KiloMing/automated-inspection-vehicle/chassis/docs/progress-2026-10-18.md

# 2026-10-18 底盘开发进度

日期按 Asia/Shanghai 记录。此文区分已编写、编译验证与实物验证。

## 今日完成

### 工程整理

- 基于 STM32F103C8、标准外设库和 Keil 工程开发。
- 清理旧 LED、Key、DHT11、MQ7、LoRa 外设业务及旧接收主程序，保留 UART、OLED、启动与系统基础文件。
- 今天最终将底盘迁移到 E:/rosfish/chassis；221 个搬移文件通过前后 SHA256 一致性校验。
- .vscode 工作区配置留在根目录，日志被编辑器占用；头文件路径已改为 chassis 下的路径。
- 将 ROS 2 上位机单独放入 E:/rosfish/upper_computer，不与 MCU 源码混合。

### 编码器

- 两路 A/B 相编码器：TIM2 PA0/PA1；TIM3 PA6/PA7。
- 硬件四倍频，有符号累计计数，处理 16 位硬件计数器回绕。
- 主循环持续读取；约 100 ms 计算窗口增量，DT 输出实际采样时间。
- 先实现转一圈计数测试，再增加增量输出反映转速。
- 每圈计数与减速比尚未确定，因此还没有输出 RPM。
- 用户曾报告运行中编码值逐渐减小：尚未收到用于定位的连续数据，原因未确认。

### TB6612 双电机

- TIM4 CH1/CH2 使用 PB6/PB7 输出 20 kHz PWM。
- AIN1/AIN2 为 PB12/PB13；BIN1/BIN2 为 PB14/PB15。
- STBY 外部拉高，不使用 PB5。
- 提供 Motor_Init、Motor_SetPWM、Motor_Brake、Motor_Coast。
- PWM 接口范围 -1000 至 1000；500 表示 50% 正向占空比，0 表示制动。
- 已加入两路 50% 测试调用；尚无速度闭环。
- 当前用户已注释 Motor_Init()，但两条 Motor_SetPWM() 仍保留。迁移时原样保留此状态，测试电机前需要整理初始化与调用配对。

### HWT101

- USART2：PA3 接模块 TX，PA2 接模块 RX，115200、8N1。
- 中断接收字节及时间戳，主循环解析 11 字节报文并校验。
- 提供 yaw 原始角、heading 相对角、continuous 连续角、相邻航向差分角速度。
- 提供最短角度误差 AngleError，处理正负 180 度跨界，供后续角度闭环调用。
- 数据有效性、帧序号、时间戳、500 ms 超时、串口错误和缓冲溢出处理。
- 断线后不猜测丢失的圈数；普通重连的连续角需重新归零。
- 用户截图显示模块可在厂商上位机以 115200 接收 0x52/0x53 帧，约 10 Hz，显示过 Z 轴角 18.605 度。
- 该截图确认的是模块到电脑通信，不代表 STM32 驱动全部功能已实物验证。

### 串口测试及命令

USART1 调试口 PA9/PA10，9600、8N1，文本模式。综合状态每 200 ms 输出。

```text
ANGLE=18.61 deg,S1=250,S2=248,DT=100
```

ANGLE 为模块原始角度；S1/S2 为最近编码器窗口增量，DT 为窗口毫秒数。

| 命令 | 功能 |
|---|---|
| r/R | 编码器清零 |
| z/Z | MCU 软件相对航向归零，ANGLE 原始角不变 |
| c/C | 发送 HWT101 模块 Z 轴归零 |
| b/B | 发送 HWT101 模块重启，不恢复出厂设置 |

模块命令先解锁再发送。返回 requested 仅表示本地发起，不能作为模块已执行确认。
处理期间显示 IMU=RESETTING，随后重新接收；缺数据时输出 NO_DATA_OR_TIMEOUT。
STM32 RESET 不会自动重启 HWT101。

## 验证记录

- 迁移后 Keil 全量编译：0 错误、0 警告。
- 固件大小：Code=10310，RO-data=398，RW-data=72，ZI-data=3736 字节。
- 编译日志：../Listings/relocation_build.log。
- HWT101 主机解析测试通过：截图报文、校验错误、混合帧、错位恢复、符号比例、跨界、整圈累计、归零、超时、逐字节重连、tick 回绕。
- 测试不代替 GPIO 电平、USART 硬件接收、模块指令执行和实物运动验证。
- 本次未烧录设备，未运行 ROS 2 仿真，未执行上下位机联调。

## 后续顺序

1. 整理电机初始化和启动策略，标定电机/编码器/IMU 的正方向。
2. 测定每圈编码计数，结合采样时间得到 RPM；定位编码增量下降问题。
3. 上板验证 HWT101 角度、归零、重启及断线恢复。
4. 根据闭环需求调整 IMU 输出频率，降低阻塞式串口输出影响。
5. 实现轮速 PID 和角度闭环，明确失联停机、输出限幅与积分复位策略。
6. 定义 ROS 2 与 STM32 通信协议，实现速度下发、轮速/航向反馈和里程计接口。

上位机原有功能见其 README；今日未将其既有仿真功能计作底盘新增成果。

## 上位机仓库拉取结果

- 仓库：git@github.com:KiloMing/automated-inspection-vehicle.git。
- 本地位置：E:/rosfish/upper_computer。
- 分支 main，提交 368e08cca4fdfe862f484ba23d50b863b817d745。
- 克隆成功，工作区干净。保留原有三个 ROS 包：mybot_description、autopatrol_interface、autopatrol_speaker。
- 仓库 README 描述已有 Gazebo、Nav2、AMCL、多点巡航、语音与拍照流程，需在对应 Ubuntu/ROS 2 环境验证。
- 22 端口超时后使用 SSH 443 完成克隆；仅配置仓库本地 SSH 选项，origin 保持用户指定地址。
- 今日只完成上位机下载与结构检查，未安装 ROS 依赖、启动仿真或提交推送。

## 同日版本管理调整

按用户要求，将 Git 管理范围由 upper_computer 提升到 E:/rosfish 根目录。
现有上位机历史保留，远端同时管理 chassis/ 与 upper_computer/。
此前“底盘尚未纳入 Git”“未提交推送”等描述是整理阶段记录，以本节后的仓库历史为准。
提交身份：KiloMing <3402684841@qq.com>。
Keil 编译产物、个人调试状态和主机测试可执行文件排除在提交之外。
