KiloMing/automated-inspection-vehicle/chapt6_ws/diagnostics/2026-10-03/hardware.txt

Hardware Component 1
	name: GazeboSystem
	type: 
	plugin name: 
	state: id=3 label=active
	read/write rate: 0 Hz
	is_async: False
	command interfaces
		left_joint/velocity [available] [unclaimed]
		right_joint/velocity [available] [unclaimed]
