KiloMing/automated-inspection-vehicle/platforms/differential_f103/firmware/docs/progress-2026-10-19.md

# 2026-10-19 开发记录

今天完成了电机速度闭环、航向闭环和蓝牙遥控的联调。最终实车反馈：小车移动正常，蓝牙控制成功。

## 电机采样与标定

从单电机阶梯 PWM 扫描开始，用 VOFA 记录每 20 ms 的编码增量和 PWM。确认轮子周长为 20 cm，每圈对应 2500 编码计数，建立编码增量到 RPM、轮缘速度的换算关系。

电机1原始数据为 `data/vofa+.csv`。按每档后半段估计稳态，在 20%～100% PWM 范围内得到：

```text
编码增量 / 20 ms ≈ 3.280042 × PWM(%) - 14.452265
车轮 RPM ≈ 3.936050 × PWM(%) - 17.342718
轮缘速度(m/s) ≈ 0.01312017 × PWM(%) - 0.05780906
```

本次上升扫描在 14% 档开始持续转动，拟合 R² 为 0.99976670。该结果用于本次工况下的速度估计，不直接外推到低速启动。原始数据、分析脚本、分档结果和曲线均保留在 data 目录。电机2也完成采集，原始数据为 `motor_2vofa+.csv`；本次没有新增电机2拟合报告。

## 双电机速度控制

将纯 PID 算法放入 MotorPID，采样、目标值和 PWM 输出封装到 MotorControl。两路各自保存积分及历史状态，使用相同增益 KP=8500、KI=2000、KD=0。

TIM1 每 20 ms 采样两路编码器。目标值接口使用计数/20 ms，PID 内部换算成 m/s，输出使用千分制 PWM。零目标清空积分并停车，采样未及时处理时停止两路输出。

遥控加入 20% 起步 PWM 下限，仅在接近静止且有驱动需求时生效。转起来后使用 PID 输出。PID 计算期间只屏蔽采样中断，让两个串口继续接收，避免换向延时阻塞接收。

## 航向控制

在 HWT101 连续角度基础上加入角度外环，由双电机速度内环执行差速目标。支持相对转角、到位保持及外界扰动后的纠偏，实车航向测试通过。

方向已确认：电机1左轮，电机2右轮；顺时针角度减小。独立 HeadingControl 接口保留，当前遥控使用自身的航向目标管理，不同时调用两套控制流程。

## 蓝牙遥控

沿用 USART1 的接线与 115200 波特率，不修改 UART.c/h。增加接收中断缓存和主循环解析，支持带空格的 `[j,LX,LY,RX,RY]` 数据包。

左 Y 控制前后，右 X 控制转向，直行保持航向，两轴回中停车。首次连接直接接受有效指令，不要求 APP 先发零值包。

联调中处理了以下问题：

- 数据包带空格，解析器需要兼容。
- 新角度帧的时间戳可能晚于函数入口时间，改为读取角度后再取当前时间，避免无符号时间差误判超时。
- APP 推住摇杆时不持续发包，原来的 300 ms 收包超时导致走一下就停；按要求关闭该判断，保持最后一条有效指令。

关闭遥控超时后，蓝牙断开不会自动触发超时停车。陀螺仪数据异常、接收错误和电机控制超时保护仍保留，故障后需要回中才能继续。

最终用户确认小车移动完全正常，蓝牙遥控成功。当前串口不发送调试数据。

## 验证与后续

已通过遥控解析、保持指令、可选超时模式、串口缓存等主机测试，Keil 固件编译为 0 错误、0 警告。主机测试用于检查软件逻辑，实车结论来自本次联调反馈，尚未测量航向精度或长时间运行误差。

上位机本次未修改业务逻辑。后续需要定义速度指令与反馈协议，接通轮速、航向和里程计，再做 ROS 2 实车导航联调。
