KiloMing/automated-inspection-vehicle/platforms/mecanum_f407/docs/daily/2026-11-04.md

# 2026-11-04 开发记录

## 用户反馈

提供 `mecanumws2`，确认为最新可使用的上位机代码，要求提交并推送 GitHub。此状态来自开发者反馈，本次未运行项目、编译、仿真或实车测试。

## 归档范围

原样同步至 `platforms/mecanum_f407/ros2_ws/`，保留原两套车型分类。旧版本可通过 Git 历史追溯。

- 更新 `config/nav2_real.yaml`。
- 更新 `start_nv2.launch.py`，默认地图改为 `/home/cat/mecanumws/maps/my_map.yaml`。
- 用 `my_map.pgm` / `my_map.yaml` 替换旧 `inspection_map` 文件。
- 新增 `mecanum_straight_planner` 包及插件声明。
- 当前配置实际启用 Navfn 与 Regulated Pure Pursuit；自定义直线规划器配置仍为注释。

## 状态与验证范围

2026-11-03 的问题记录不改写。本次将最新状态更新为用户确认可用，尚未提供测试路线、定位/跟踪误差、成功率或各问题关闭情况。

仅核对同步文件和 Git 提交状态，不据此声称构建或测试通过。源目录名称为 mecanumws2，代码中的板端默认路径仍为 /home/cat/mecanumws；本次不修改用户提供的部署路径。
