KiloMing/automated-inspection-vehicle/platforms/mecanum_f407/docs/daily/2026-11-03.md

# 2026-11-03 开发记录

## 当日进展（用户现场反馈）

- 已完成麦克纳姆小车实物平台上的 Nav2 部署与初步导航联调。
- 当前上位机为鲁班猫 RK3588。
- 使用 Nav2 提供的路径规划与控制组件，实车仍出现路径跟踪与底盘运动偏差，无法正常完成导航。
- 补充底盘装配照片、商家底盘/麦轮尺寸截图、电机编码器资料和维特智能文档链接。

## 状态结论

已进入实车导航联调阶段，尚未通过正常导航验收。用户认为规划与底盘控制存在偏差；具体根因尚未通过日志和测量确定。本记录不将问题归因于某个算法。

## 本次仓库整理

将 F103 固件、二轮差速仿真和旧资料归为一类；F407 固件、麦轮实车工作区及硬件资料归为一类。新增详细 README、硬件索引、原始图片和每日记录。

源码基线为 96b41a1；该版本仅表示分析所依据的仓库版本，不表示板端实际烧录/运行版本。本次未运行项目代码、编译、仿真或硬件测试。

## 待补充实验条件

鲁班猫具体型号、Ubuntu/ROS 2 版本、实际固件提交号、地图版本、启动参数、测试场地、目标点和偏差数值尚未提供。当前不填写推测数值。

## 下一步实验建议

1. 修复并验证运动指令隔离。
2. 独立验证前进、横移与旋转，记录轮序、方向和实际位移。
3. 测量每圈编码器计数、轮中心距、有效轮径并核对固件参数。
4. 对比实际位移、odom、TF 与地图定位。
5. 同步保存速度指令、里程计、激光及 TF 数据，再判断导航参数调整方向。

这些是后续计划，本次没有执行。
