KiloMing/automated-inspection-vehicle/chapt6_ws/photo/C.jpg

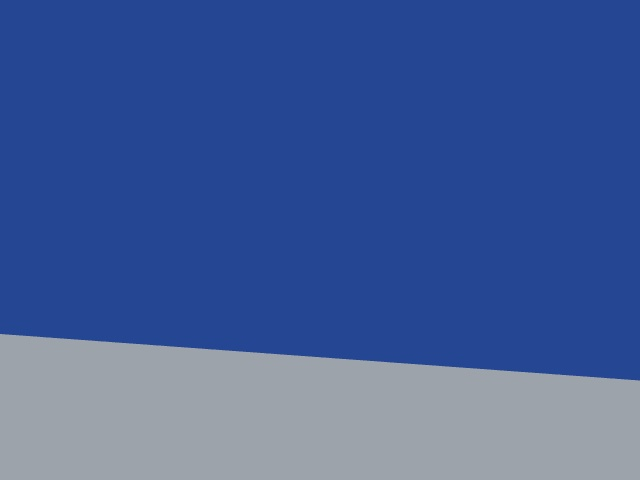
chapt6_ws/photo/C.jpg
