KiloMing/automated-inspection-vehicle/chapt6_ws/photo/D.jpg

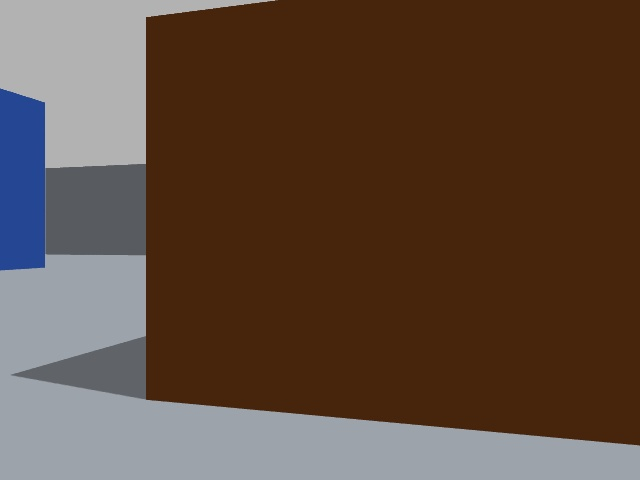
chapt6_ws/photo/D.jpg
