KiloMing/automated-inspection-vehicle/chapt6_ws/photo/photoB.jpg

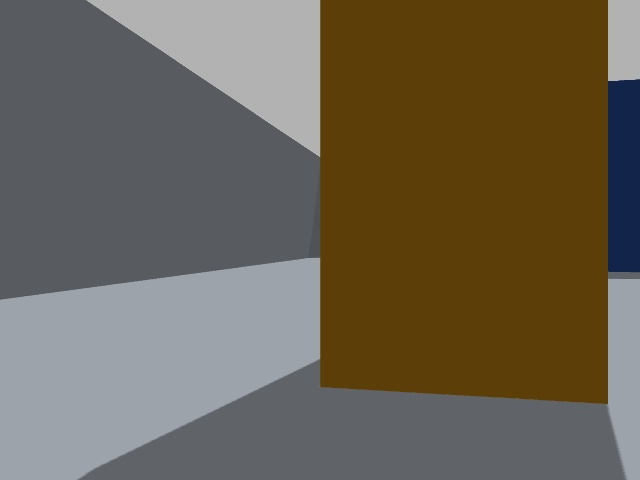
chapt6_ws/photo/photoB.jpg
