KiloMing/automated-inspection-vehicle/upper_computer/docs/images/camsense-x1-mapping-2026-10-23.jpg

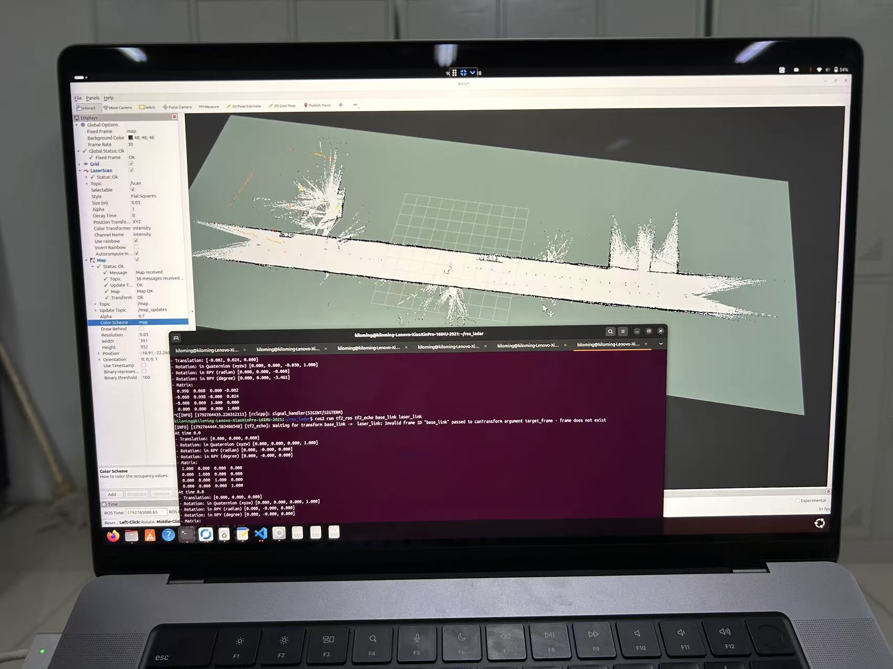
upper_computer/docs/images/camsense-x1-mapping-2026-10-23.jpg
