KiloMing/automated-inspection-vehicle/platforms/differential_f103/firmware/docs/motor1-calibration-2026-10-19.md

# 电机 1 标定结果记录（2026-10-19）

## 数据与测试条件

- 原始数据：[vofa+.csv](../../data/vofa+.csv)，2795 个采样点，一次完整上升扫描。
- 分档统计：[motor1_calibration.csv](../../data/motor1_calibration.csv)。
- 分析报告与曲线：[报告](../../data/motor1_calibration.md)、[曲线](../../data/motor1_calibration.png)。
- 仅测试电机 1 当前扫描方向，串口 115200，通道依次为编码增量、PWM 百分比。
- 采样周期按固件配置 20 ms；每档保持 1 s，PWM 每档增加 2%。
- 每个非零 PWM 档有 50 点，取后 25 点平均，排除前半段加速过程。
- 车轮每圈 2500 计数，周长 0.20 m。CSV 无时间戳，无法独立确认实际采样周期和丢包情况。
- 供电电压、负载及是否架空未记录；本次参数不能视为所有工况通用值。

## 测量结果

| PWM (%) | 平均编码增量/20 ms | 车轮 RPM | 轮缘速度 (m/s) |
|---:|---:|---:|---:|
| 12 | 0.00 | 0.00 | 0.0000 |
| 14 | 30.56 | 36.67 | 0.1222 |
| 20 | 50.56 | 60.67 | 0.2022 |
| 30 | 83.24 | 99.89 | 0.3330 |
| 40 | 116.92 | 140.30 | 0.4677 |
| 50 | 149.68 | 179.62 | 0.5987 |
| 60 | 182.36 | 218.83 | 0.7294 |
| 70 | 216.28 | 259.54 | 0.8651 |
| 80 | 249.80 | 299.76 | 0.9992 |
| 90 | 280.64 | 336.77 | 1.1226 |
| 100 | 309.48 | 371.38 | 1.2379 |

本次扫描在 14% 开始持续转动；这是此次上升扫描的观察值，不是已验证的通用启动阈值。

## 换算与拟合

令 N 为每 20 ms 编码增量，P 为 PWM 百分数（50 表示 50%），v 为轮缘速度（m/s）。

```text
RPM = 1.2 × N
v = 0.004 × N

N   ≈ 3.280042 × P − 14.452265
RPM ≈ 3.936050 × P − 17.342718
v   ≈ 0.01312017 × P − 0.05780906

P ≈ (v + 0.05780906) / 0.01312017
P ≈ (目标 RPM + 17.342718) / 3.936050
```

拟合使用 20%～100% 的 41 个档位均值，R² = 0.99976670，最大绝对残差为 4.072 计数/20 ms。
公式用于本次测试条件下的前馈初值，不外推到低速启动区。

驱动接口使用千分制：`Motor_SetPWM(1, u)` 中 `u ≈ 10 × P`。
例如目标 0.6 m/s，P 约 50.14%，u 约 501。
目标速度为 0 时直接输出 0；非零输出需限幅，低速启动策略另行实现。
轮缘速度不等于打滑条件下的车辆实际地速。

## 后续控制依据

采用目标速度到 PWM 的前馈，再用编码器速度反馈和 PI 修正负载、电压变化。
电机 2、反向、不同负载及启动/降速特性仍需单独测试。
本次仅记录标定结果，尚未将拟合公式或速度闭环加入固件。
