KiloMing/automated-inspection-vehicle/platforms/differential_f103/ros2_ws/diagnostics/2026-10-03/test-controllers.txt

codex_verify_joints   joint_state_broadcaster/JointStateBroadcaster        active
codex_verify_velocity forward_command_controller/ForwardCommandController  active
