KiloMing/automated-inspection-vehicle/platforms/differential_f103/calibration/motor_2vofa+.csv

I0 | I1
0.000000 | 0.000000
0.000000 | 0.000000
0.000000 | 0.000000
0.000000 | 0.000000
0.000000 | 0.000000
0.000000 | 0.000000
0.000000 | 0.000000
0.000000 | 0.000000
0.000000 | 0.000000
0.000000 | 0.000000
0.000000 | 0.000000
0.000000 | 0.000000
0.000000 | 0.000000
0.000000 | 0.000000
0.000000 | 0.000000
0.000000 | 0.000000
0.000000 | 0.000000
0.000000 | 0.000000
0.000000 | 0.000000
0.000000 | 0.000000
0.000000 | 0.000000
0.000000 | 0.000000
0.000000 | 0.000000
0.000000 | 0.000000
0.000000 | 0.000000
0.000000 | 0.000000
0.000000 | 0.000000
0.000000 | 0.000000
0.000000 | 0.000000
0.000000 | 0.000000
0.000000 | 0.000000
0.000000 | 0.000000
0.000000 | 0.000000
0.000000 | 0.000000
0.000000 | 0.000000
0.000000 | 0.000000
0.000000 | 0.000000
0.000000 | 0.000000
0.000000 | 0.000000
0.000000 | 0.000000
0.000000 | 0.000000
0.000000 | 0.000000
0.000000 | 0.000000
0.000000 | 0.000000
0.000000 | 0.000000
0.000000 | 0.000000
0.000000 | 0.000000
0.000000 | 0.000000
0.000000 | 0.000000
0.000000 | 0.000000
0.000000 | 0.000000
0.000000 | 0.000000
0.000000 | 0.000000
0.000000 | 0.000000
0.000000 | 0.000000
0.000000 | 0.000000
0.000000 | 0.000000
0.000000 | 0.000000
0.000000 | 0.000000
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
