KiloMing/automated-inspection-vehicle/data/motor1_calibration.csv

pwm_percent | samples | encoder_mean | encoder_std | encoder_min | encoder_max | wheel_rpm | wheel_speed_m_s
2 | 25 | 0.000000 | 0.000000 | 0.000000 | 0.000000 | 0.000000 | 0.000000
4 | 25 | 0.000000 | 0.000000 | 0.000000 | 0.000000 | 0.000000 | 0.000000
6 | 25 | 0.000000 | 0.000000 | 0.000000 | 0.000000 | 0.000000 | 0.000000
8 | 25 | 0.000000 | 0.000000 | 0.000000 | 0.000000 | 0.000000 | 0.000000
10 | 25 | 0.000000 | 0.000000 | 0.000000 | 0.000000 | 0.000000 | 0.000000
12 | 25 | 0.000000 | 0.000000 | 0.000000 | 0.000000 | 0.000000 | 0.000000
14 | 25 | 30.560000 | 0.583095 | 29.000000 | 31.000000 | 36.672000 | 0.122240
16 | 25 | 37.360000 | 0.489898 | 37.000000 | 38.000000 | 44.832000 | 0.149440
18 | 25 | 44.000000 | 0.408248 | 43.000000 | 45.000000 | 52.800000 | 0.176000
20 | 25 | 50.560000 | 0.506623 | 50.000000 | 51.000000 | 60.672000 | 0.202240
22 | 25 | 57.080000 | 0.400000 | 56.000000 | 58.000000 | 68.496000 | 0.228320
24 | 25 | 63.720000 | 0.458258 | 63.000000 | 64.000000 | 76.464000 | 0.254880
26 | 25 | 70.160000 | 0.374166 | 70.000000 | 71.000000 | 84.192000 | 0.280640
28 | 25 | 76.680000 | 0.476095 | 76.000000 | 77.000000 | 92.016000 | 0.306720
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
