KiloMing/automated-inspection-vehicle/docs/f407-development-history.md

## 当前坐标遥测：24 字节二进制包（替代所有下文文本坐标格式）

50Hz、115200 8N1、异步发送；无换行或帧尾。运动命令仍为 `[v,x,y,z]`，20Hz 持续发送，300ms 超时停车。

|偏移|字段|格式|
|---|---|---|
|0..1|帧头|AA 55|
|2|类型|01|
|3|整帧长度|18（十六进制，24字节）|
|4..5|序号|uint16，小端，从0递增并回绕，忙时丢帧也递增|
|6..9|时间戳|uint32，小端，上电毫秒数|
|10..13|X|IEEE754 float32，小端，米|
|14..17|Y|IEEE754 float32，小端，米|
|18..21|O|IEEE754 float32，小端，度，左正右负，相对归零方向|
|22..23|CRC|CRC16/MODBUS，初值FFFF，多项式A001，覆盖前22字节，低字节先，无最终异或|

坐标失效时三个浮点字段均为 quiet NaN（原始位 0x7FC00000）。上位机按帧头缓存满24字节，核对类型、长度和CRC后解析，CRC错误时滑动一字节重新同步；不能把一次接收当成一帧。不能再用 FireWater 直接解析。

测试样例：序号100、时间8000ms、X=0.12m、Y=0.05m、O=90度：

```text
AA 55 01 18 64 00 40 1F 00 00 8F C2 F5 3D CD CC 4C 3D 00 00 B4 42 55 0C
```

仅完成源码修改与主机侧协议计算检查，未编译固件或烧录。

## 运动命令超时保护

上位机以 20Hz 连续发送 `[v,x,y,z]`，无需改变帧格式。每次有效命令更新速度与接收时间；300ms 无有效命令立即输出停止并清零积分，超时期间禁用航向辅助输出。恢复有效命令后自动恢复控制。启动前 5 秒的命令仍丢弃，上位机持续发送即可在初始化后接管。

超时参数：`ChassisConfig.h` 中 `CHASSIS_COMMAND_TIMEOUT_MS=300U`。坐标 `x,y,o` 保持 50Hz 非阻塞发送。停止指令为 `[v,0,0,0]`；超时停止表示停止驱动输出，机械滑行距离需实测。本次未编译或烧录。

## 当前版本：编码器 + HWT101 平面里程计

- 使用四轮实际编码器速度，经麦克纳姆正运动学得到车体 vx/vy，再使用 HWT101 航向转换并积分；不是加速度积分，也不使用目标速度代替实测速度。
- 上电前 5 秒保持静止；5 秒软件复位编码器、PID、位置及航向。位置为 (0,0)，X 为此时车头前方，Y 为左方，单位米。
- 原蓝牙命令 `[v,x,y,z]` 保持不变，单位 m/s、m/s、rad/s；启动期间命令丢弃，复位后重新发送。上位机必须以 20Hz（每 50ms）持续发送完整有效运动命令；连续 300ms 未收到有效命令则停止四轮、清零目标与 PID 积分，收到新有效命令后恢复。无效帧不刷新超时计时。
- USART3 / 蓝牙 115200 8N1，每 20ms（50Hz）发送 `x,y,o\r\n`，FireWater 三通道；x/y 单位米，o 为相对归零方向的角度（度），左转为正，范围 [-180,180)；替换原来的 12 通道 PID 遥测。
- `Chassis_GetPose()` 返回 x_m、y_m、yaw_rad 和 valid。若启动归零时没有新鲜航向，或运行中航向无效/超过 300ms 未更新，停止坐标积分，串口发送 `nan,nan,nan`；恢复传感器后需静止重启重新建原点。该状态不改变电机命令，不新增停车逻辑。
- 遥测周期在 `ChassisConfig.h` 的 `CHASSIS_TELEMETRY_PERIOD_MS` 配置，当前 20ms；控制计算后异步发送，串口忙时跳帧，不阻塞等待。50Hz 为配置频率，实测频率需上板验证。
- 轮径 80mm，每圈 4000 编码计数；前后/左右轮中心距各 195mm。坐标是轮式里程估计，打滑和航向漂移会累积误差。
- 验证：静止归零后应接近 0,0；前进 X 增加，左移 Y 增加；原地左转约 90° 后再前进，主要应为 Y 增加。先核实四轮正向反馈均为正。
- 本次只修改源文件和文档，没有编译、生成 HEX 或烧录。以下为此前记录；输出格式以本节为准。

# 最新实测反馈修正

VOFA前进0.05m/s实测：A目标796、反馈700～900；BCD目标796、反馈约-7500且输出100%。据此仅反转BCD反馈系数，现为A=-1、B=-1、C=+1、D=+1，不改电机输出方向和PID参数。须另行确认四轮物理方向确实前进。本次未编译。

# 上电5秒底盘软件校准

上电前5秒保持四轮PWM为零，速度指令忽略且不缓存。到5秒后一次性清零四轮编码器计数、目标速度、PID积分及历史反馈；HWT101有效时设置当前航向零点，无有效数据时不能完成航向置零。无机械找零、无MCU重启。校准后需重新发送[v,x,y,z]才运动；请前5秒保持车体静止。HWT辅助默认仍关闭。本次只修改源码，未编译。

# F407 麦克纳姆底盘

当前入口为四轮速度PID+麦克纳姆运动学。仅修改源码，未编译、未烧录；旧HEX不能代表本版。

## 参数

轮径80mm、轴距195mm、轮距195mm、四轮4000计数/圈。轮序A左前、B左后、C右前、D右后。ChassisConfig.h集中配置。四轮PID初值复制当前A参数：Kp=1.5、Ki=0.2、Kd=0，误差单位计数/秒，输出千分比。每轮积分独立，输出±100%。可通过WheelPID_SetGains分别调整。

四轮统一限速0.48m/s（由A空载测试约0.484m/s取初值，并非负载保证值）；混合运动超限时同比缩小。方向在motor.c和MotorEncoder.h中分别配置，BCD仍需验证正目标/正反馈。

## 蓝牙串口

PC10 TX、PC11 RX，115200/8N1。发送ASCII文本[v,x,y,z]：x前进m/s，y左移m/s，z左转rad/s。只识别完整速度包；不支持此前[j,...]摇杆包或A单轮[v,3000]命令。

- [v,0.05,0,0]：低速前进
- [v,-0.05,0,0]：后退
- [v,0,0.05,0]：左移
- [v,0,0,0.3]：原地左转
- [v,0,0,0]：速度归零

上电目标零；单包持续生效到下一有效包。无额外使能、无零点确认、无通信静默停车、无反馈故障锁定、无500ms换向等待。无效帧和UART接收错误丢弃，不改变上一目标。输入数值合理性范围x/y±10m/s、z±20rad/s，实际轮速再受同比限速约束。断连不会自动停车。

## VOFA

FireWater每50ms回传12路，按A/B/C/D各3路排列：目标计数/秒、实际计数/秒、有符号PWM百分比。不是累计位置。蓝牙命令与遥测使用同一串口。

## HWT101

PA3接传感器TX，115200。默认仅采集，CHASSIS_HEADING_DEFAULT=0。四轮运动验证完成后可设为1或调用Chassis_EnableHeadingAssist(1)。z非零时角速度修正，z为零时锁定当前航向；重复零旋转命令不重置参考。传感器无效时仅退出修正，继续原速度指令。默认关闭时[v,0,0,0]各轮PWM归零；启用航向保持时零平移/零旋转仍可能为纠正偏转而转轮。

## 接口与验证

Mecanum.h：正逆运动学、轮速限幅、计数/秒与m/s转换。
ChassisControl.h：设置持续速度、周期更新、读取估计车速、设置四轮增益、选择航向辅助。
主循环调用Chassis_Update；旧MotorATune、MotorControl保留供参考但不调用。

先架空验证四轮前进与编码反馈符号，再低速落地验证前后、横移、旋转。几何公式验证不等于实际无打滑。现有A参数直接复制到BCD，不表示BCD已经完成整定。
