KiloMing/automated-inspection-vehicle/upper_computer/chapt6_ws/diagnostics/2026-10-02/before/second_robot.urdf

<?xml version="1.0" ?>
<!-- =================================================================================== -->
<!-- |    This document was autogenerated by xacro from src/mybot_description/urdf/second_robot/second_robot.urdf.xacro | -->
<!-- |    EDITING THIS FILE BY HAND IS NOT RECOMMENDED                                 | -->
<!-- =================================================================================== -->
<robot name="second_robot">
  <ros2_control name="GazeboSystem" type="system">
    <hardware>
      <plugin>gz_ros2_control/GazeboSimSystem</plugin>
    </hardware>
    <joint name="left_joint">
      <command_interface name="velocity"/>
      <state_interface name="position"/>
      <state_interface name="velocity"/>
    </joint>
    <joint name="right_joint">
      <command_interface name="velocity"/>
      <state_interface name="position"/>
      <state_interface name="velocity"/>
    </joint>
  </ros2_control>
  <gazebo>
    <plugin filename="libgz_ros2_control-system.so" name="gz_ros2_control::GazeboSimROS2ControlPlugin">
            </plugin>
    <parameters>
            /home/kiloming/my_ros/chapt6_ws/install/mybot_description/share/mybot_description/config/ros2_control.yaml
        </parameters>
  </gazebo>
  <link name="base_link">
    <!-- visual -->
    <visual>
      <origin rpy="0 0 0" xyz="0 0 0"/>
      <geometry>
        <cylinder length="0.12" radius="0.1"/>
      </geometry>
      <material name="while">
        <color rgba="1.0 1.0 1.0 1"/>
      </material>
    </visual>
    <!-- collision -->
    <collision>
      <origin rpy="0 0 0" xyz="0 0 0"/>
      <geometry>
        <cylinder length="0.12" radius="0.1"/>
      </geometry>
    </collision>
    <inertial>
      <mass value="0.5"/>
      <inertia ixx="0.0018500000000000003" ixy="0.0" ixz="0.0" iyy="0.0018500000000000003" iyz="0.0" izz="0.0025000000000000005"/>
    </inertial>
  </link>
  <link name="base_footprint"/>
  <joint name="base_joint" type="fixed">
    <parent link="base_footprint"/>
    <child link="base_link"/>
    <origin rpy="0 0 0" xyz="0 0 0.091"/>
  </joint>
  <link name="imu_link">
    <visual>
      <origin rpy="0 0 0" xyz="0 0 0"/>
      <geometry>
        <box size="0.04 0.03 0.01"/>
      </geometry>
      <material name="imu_blue">
        <color rgba="0 0 1 1"/>
      </material>
    </visual>
  </link>
  <joint name="imu_joint" type="fixed">
    <parent link="base_link"/>
    <child link="imu_link"/>
    <origin rpy="0 0 0" xyz="0 0 0.08"/>
  </joint>
  <gazebo reference="imu_link">
    <sensor name="imu_sensor" type="imu">
      <always_on>true</always_on>
      <update_rate>50</update_rate>
      <topic>imu</topic>
    </sensor>
  </gazebo>
  <!-- laser link -->
  <link name="laser_link">
    <visual>
      <origin rpy="0 0 0" xyz="0 0 0"/>
      <geometry>
        <cylinder length="0.03" radius="0.04"/>
      </geometry>
      <material name="laser_black">
        <color rgba="0.1 0.1 0.1 1"/>
      </material>
    </visual>
    <collision>
      <origin rpy="0 0 0" xyz="0 0 0"/>
      <geometry>
        <cylinder length="0.03" radius="0.04"/>
      </geometry>
    </collision>
    <inertial>
      <mass value="0.3"/>
      <inertia ixx="0.00014249999999999997" ixy="0.0" ixz="0.0" iyy="0.00014249999999999997" iyz="0.0" izz="0.00024"/>
    </inertial>
  </link>
  <link name="laser_cylinder_link">
    <visual>
      <origin rpy="0.0 0.0 0.0" xyz="0.0 0.0 0.0"/>
      <geometry>
        <cylinder length="0.10" radius="0.01"/>
      </geometry>
      <material name="black">
        <color rgba="0.0 0.0 0.0 1.0"/>
      </material>
    </visual>
    <collision>
      <origin rpy="0 0 0" xyz="0 0 0"/>
      <geometry>
        <cylinder length="0.10" radius="0.01"/>
      </geometry>
    </collision>
    <inertial>
      <mass value="0.3"/>
      <inertia ixx="0.0002575" ixy="0.0" ixz="0.0" iyy="0.0002575" iyz="0.0" izz="1.5e-05"/>
    </inertial>
  </link>
  <joint name="laser_joint" type="fixed">
    <parent link="base_link"/>
    <child link="laser_cylinder_link"/>
    <origin rpy="0 0 0" xyz="0 0 0.10"/>
  </joint>
  <joint name="laser_cylinder_joint" type="fixed">
    <origin rpy="0.0 0.0 0.0" xyz="0.0 0.0 0.05"/>
    <parent link="laser_cylinder_link"/>
    <child link="laser_link"/>
  </joint>
  <gazebo reference="laser_link">
    <sensor name="laser_sensor" type="gpu_lidar">
      <always_on>true</always_on>
      <update_rate>10</update_rate>
      <topic>scan</topic>
      <gz_frame_id>laser_link</gz_frame_id>
      <visualize>true</visualize>
      <lidar>
        <scan>
          <horizontal>
            <samples>360</samples>
            <resolution>1</resolution>
            <min_angle>-3.14159</min_angle>
            <max_angle>3.14159</max_angle>
          </horizontal>
        </scan>
        <range>
          <min>0.10</min>
          <max>10.0</max>
          <resolution>0.01</resolution>
        </range>
      </lidar>
    </sensor>
  </gazebo>
  <link name="camera_link">
    <visual>
      <origin rpy="0 0 0" xyz="0 0 0"/>
      <geometry>
        <box size="0.05 0.04 0.03"/>
      </geometry>
      <material name="camera_green">
        <color rgba="0 1 0 1"/>
      </material>
    </visual>
    <collision>
      <origin rpy="0 0 0" xyz="0 0 0"/>
      <geometry>
        <box size="0.05 0.04 0.03"/>
      </geometry>
    </collision>
    <inertial>
      <mass value="0.05"/>
      <inertia ixx="1.0416666666666666e-05" ixy="0.0" ixz="0.0" iyy="1.4166666666666668e-05" iyz="0.0" izz="1.7083333333333333e-05"/>
    </inertial>
  </link>
  <joint name="camera_joint" type="fixed">
    <parent link="base_link"/>
    <child link="camera_link"/>
    <origin rpy="0 0 0" xyz="0.08 0 0.075"/>
  </joint>
  <gazebo reference="camera_link">
    <sensor name="camera_sensor" type="rgbd_camera">
      <always_on>true</always_on>
      <update_rate>30</update_rate>
      <topic>/camera</topic>
      <camera>
        <horizontal_fov>1.047</horizontal_fov>
        <image>
          <width>640</width>
          <height>480</height>
        </image>
        <clip>
          <near>0.1</near>
          <far>10.0</far>
        </clip>
      </camera>
    </sensor>
  </gazebo>
  <link name="front_link">
    <visual>
      <origin rpy="0 0 0" xyz="0 0 0"/>
      <geometry>
        <sphere radius="0.016"/>
      </geometry>
      <material name="yellow">
        <color rgba="1 1 0 0.5"/>
      </material>
    </visual>
    <collision>
      <origin rpy="0 0 0" xyz="0 0 0"/>
      <geometry>
        <sphere radius="0.016"/>
      </geometry>
    </collision>
    <inertial>
      <mass value="0.05"/>
      <inertia ixx="5.120000000000002e-06" ixy="0.0" ixz="0.0" iyy="5.120000000000002e-06" iyz="0.0" izz="5.120000000000002e-06"/>
    </inertial>
  </link>
  <joint name="front_joint" type="fixed">
    <parent link="base_link"/>
    <child link="front_link"/>
    <origin rpy="0 0 0" xyz="0.08 0 -0.076"/>
  </joint>
  <gazebo reference="front_link">
    <mu1>0.0</mu1>
    <mu2>0.0</mu2>
    <kp>1000000000.0</kp>
    <kd>1.0</kd>
  </gazebo>
  <link name="back_link">
    <visual>
      <origin rpy="0 0 0" xyz="0 0 0"/>
      <geometry>
        <sphere radius="0.016"/>
      </geometry>
      <material name="yellow">
        <color rgba="1 1 0 0.5"/>
      </material>
    </visual>
    <collision>
      <origin rpy="0 0 0" xyz="0 0 0"/>
      <geometry>
        <sphere radius="0.016"/>
      </geometry>
    </collision>
    <inertial>
      <mass value="0.05"/>
      <inertia ixx="5.120000000000002e-06" ixy="0.0" ixz="0.0" iyy="5.120000000000002e-06" iyz="0.0" izz="5.120000000000002e-06"/>
    </inertial>
  </link>
  <joint name="back_joint" type="fixed">
    <parent link="base_link"/>
    <child link="back_link"/>
    <origin rpy="0 0 0" xyz="-0.08 0 -0.076"/>
  </joint>
  <gazebo reference="back_link">
    <mu1>0.0</mu1>
    <mu2>0.0</mu2>
    <kp>1000000000.0</kp>
    <kd>1.0</kd>
  </gazebo>
  <link name="left_link">
    <visual>
      <origin rpy="1.5708 0 0" xyz="0 0 0"/>
      <geometry>
        <cylinder length="0.04" radius="0.032"/>
      </geometry>
      <material name="yellow">
        <color rgba="1 1 0 0.5"/>
      </material>
    </visual>
    <!-- add collision -->
    <collision>
      <origin rpy="1.5708 0 0" xyz="0 0 0"/>
      <geometry>
        <cylinder length="0.04" radius="0.032"/>
      </geometry>
    </collision>
    <inertial>
      <mass value="0.05"/>
      <inertia ixx="1.9466666666666668e-05" ixy="0.0" ixz="0.0" iyy="1.9466666666666668e-05" iyz="0.0" izz="2.5600000000000002e-05"/>
    </inertial>
  </link>
  <joint name="left_joint" type="continuous">
    <parent link="base_link"/>
    <child link="left_link"/>
    <origin rpy="0 0 0" xyz="0 0.11 -0.06"/>
    <axis xyz="0 1 0"/>
    <!-- ??-->
  </joint>
  <link name="right_link">
    <visual>
      <origin rpy="1.5708 0 0" xyz="0 0 0"/>
      <geometry>
        <cylinder length="0.04" radius="0.032"/>
      </geometry>
      <material name="yellow">
        <color rgba="1 1 0 0.5"/>
      </material>
    </visual>
    <!-- add collision -->
    <collision>
      <origin rpy="1.5708 0 0" xyz="0 0 0"/>
      <geometry>
        <cylinder length="0.04" radius="0.032"/>
      </geometry>
    </collision>
    <inertial>
      <mass value="0.05"/>
      <inertia ixx="1.9466666666666668e-05" ixy="0.0" ixz="0.0" iyy="1.9466666666666668e-05" iyz="0.0" izz="2.5600000000000002e-05"/>
    </inertial>
  </link>
  <joint name="right_joint" type="continuous">
    <parent link="base_link"/>
    <child link="right_link"/>
    <origin rpy="0 0 0" xyz="0 -0.11 -0.06"/>
    <axis xyz="0 1 0"/>
    <!-- ??-->
  </joint>
  <!-- 
    <gazebo>
        <plugin filename="gz-sim-diff-drive-system" name="gz::sim::systems::DiffDrive">

            <left_joint>left_joint</left_joint>
            <right_joint>right_joint</right_joint>

            <wheel_separation>0.22</wheel_separation>
            <wheel_radius>0.032</wheel_radius>

            <topic>cmd_vel</topic>

        </plugin>
    </gazebo>
    -->
</robot>
