KiloMing/automated-inspection-vehicle/(commit log)

2026-10-19 Organize upper computer and add STM32 chassis drivers and progress notes
2026-10-19 完成底盘速度与航向闭环、蓝牙遥控并整理开发记录
2026-10-20 记录ELF3588上位机及Ubuntu 22.04、ROS 2和SSH环境
2026-10-23 docs: record Camsense X1 lidar mapping basic test with source and photo
2026-11-02 feat: add F407 mecanum chassis firmware and migration documentation
2026-11-03 feat: add mecanum ROS 2 workspace with chassis bridge and lidar navigation
